JetstreamSR/iot-smart-mushroom-box/frost/README.md

# FROST SensorThings configuration

`channel_mapping.js` connects the five Cayenne LPP channels used by the device to the corresponding FROST Datastreams. The device identifier is read from an environment variable.

## Historical channel mapping

| Cayenne LPP channel | Measurement | FROST Datastream |
| ---: | --- | ---: |
| 1 | Box temperature | [1507](https://gi3.gis.lrg.tum.de/frost/v1.1/Datastreams(1507)) |
| 2 | Growing-medium moisture | [1508](https://gi3.gis.lrg.tum.de/frost/v1.1/Datastreams(1508)) |
| 3 | Illuminance | [1670](https://gi3.gis.lrg.tum.de/frost/v1.1/Datastreams(1670)) |
| 4 | Indoor air quality | [1671](https://gi3.gis.lrg.tum.de/frost/v1.1/Datastreams(1671)) |
| 5 | Box humidity | [1673](https://gi3.gis.lrg.tum.de/frost/v1.1/Datastreams(1673)) |

The public FROST server still returns metadata and observations for the project. Because it is course infrastructure, availability and write permissions may change.

## Saved API metadata

The `snapshots/` directory contains formatted JSON files for the project Thing and every Datastream used by the box and weather dashboard. These files preserve the SensorThings structure directly in the repository and can be read without contacting the live service.

## Download archived observations

The downloader uses only Python's standard library:

```bash
python frost/download_observations.py --output data/frost_observations.csv
```

It requests the five box Datastreams and the two Munich weather Datastreams, follows SensorThings pagination links, and writes one CSV file. By default it keeps at most 1,000 observations from each Datastream to avoid an unexpectedly large download. Pass `--max-per-stream 0` to retrieve every available observation.
