JetstreamSR/iot-smart-mushroom-box/firmware/examples/bme680_test/bme680_test.ino

#include "seeed_bme680.h"
#define PIN_GROVE_POWER 38
#define BME_SCK 13
#define BME_MISO 12
#define BME_MOSI 11
#define BME_CS 10
#include <Wire.h>

#define IIC_ADDR  uint8_t(0x76)


/**  NOTE!!!!!!!!!!!!  Select the communication protocol correctly **/

Seeed_BME680 bme680(IIC_ADDR); /* IIC PROTOCOL */
//Seeed_BME680 bme680;             /* SPI PROTOCOL */
//Seeed_BME680 bme680(BME_CS, BME_MOSI, BME_MISO,  BME_SCK);/*SPI PROTOCOL*/

void setup() {
    Serial.begin(9600);
    while (!Serial);
    Wire.begin();
    pinMode(PIN_GROVE_POWER, OUTPUT);
    digitalWrite(PIN_GROVE_POWER, HIGH);  // ← 打开电源
    Serial.println("Power to Grove enabled");
    delay(100);
    Serial.println("Serial start!!!");
    delay(100);
    while (!bme680.init()) {
        Serial.println("bme680 init failed ! can't find device!");
        delay(10000);
    }
}

void loop() {
    if (bme680.read_sensor_data()) {
        Serial.println("Failed to perform reading :(");
        return;
    }
    Serial.print("temperature ===>> ");
    Serial.print(bme680.sensor_result_value.temperature);
    Serial.println(" C");

    Serial.print("pressure ===>> ");
    Serial.print(bme680.sensor_result_value.pressure / 1000.0);
    Serial.println(" KPa");

    Serial.print("humidity ===>> ");
    Serial.print(bme680.sensor_result_value.humidity);
    Serial.println(" %");

    Serial.print("gas ===>> ");
    Serial.print(bme680.sensor_result_value.gas / 1000.0);
    Serial.println(" Kohms");

    Serial.println();
    Serial.println();

    delay(2000);
}
