JetstreamSR/iot-smart-mushroom-box/firmware/examples/light_sensor_test/light_sensor_test.ino

/*
    Digital_Light_Sensor.ino
    A library for TSL2561

    Copyright (c) 2012 seeed technology inc.
    Website    : www.seeed.cc
    Author     : zhangkun
    Create Time:
    Change Log :

    The MIT License (MIT)

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
    THE SOFTWARE IS PROVIDED "AS IS", WITHOUT WARRANTY OF ANY KIND, EXPRESS OR
    IMPLIED, INCLUDING BUT NOT LIMITED TO THE WARRANTIES OF MERCHANTABILITY,
    FITNESS FOR A PARTICULAR PURPOSE AND NONINFRINGEMENT. IN NO EVENT SHALL THE
    AUTHORS OR COPYRIGHT HOLDERS BE LIABLE FOR ANY CLAIM, DAMAGES OR OTHER
    LIABILITY, WHETHER IN AN ACTION OF CONTRACT, TORT OR OTHERWISE, ARISING FROM,
    OUT OF OR IN CONNECTION WITH THE SOFTWARE OR THE USE OR OTHER DEALINGS IN
    THE SOFTWARE.
*/
#define PIN_GROVE_POWER 38
#include <Wire.h>
#include <Digital_Light_TSL2561.h>
void setup() {
    Wire.begin();
    Serial.begin(9600);
    TSL2561.init();
}

void loop() {
    Serial.print("The Light value is: ");
    Serial.println(TSL2561.readVisibleLux());
    delay(1000);
}
