JetstreamSR/iot-smart-mushroom-box/firmware/smart_mushroom_box/secrets.example.h

#pragma once

// Copy this file to secrets.h and replace each placeholder.
// Never commit the populated secrets.h file.

#define LORAWAN_DEV_EUI "YOUR_DEVICE_EUI"
#define LORAWAN_APP_EUI "YOUR_APPLICATION_EUI"
#define LORAWAN_APP_KEY "YOUR_APPLICATION_KEY"
